nezhadian/IOT2024/Scheme/Fan Speed.png

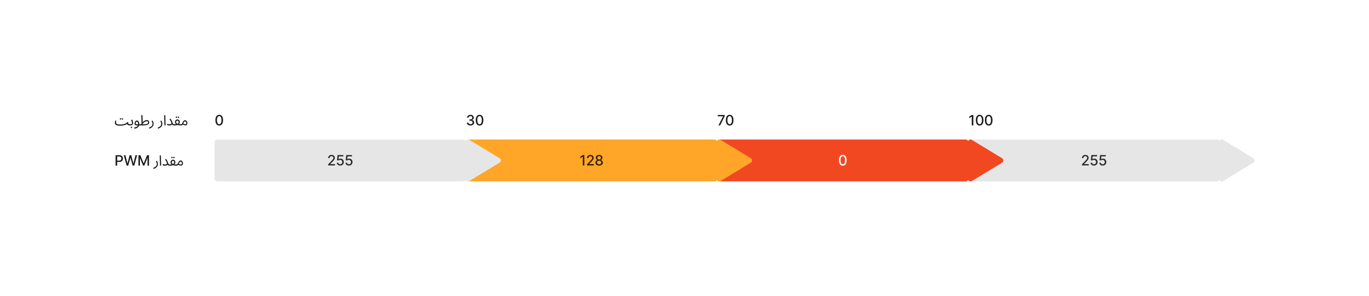
Scheme/Fan Speed.png
